Gallard88/Laptop_UPS_PCB/README.md

Laptop UPS PCB
--------

This is a PCB project to provide a 12V & 5V rail to power my ODroid based laptop.
This PCB can source 12V & 5V 4A. It is powered by a 15 - 35V DC supply and upto 
2x 12V SLA batteries.
