Gallard88/Laptop_UPS_PCB/Testing/LaptopPower_RevA.FootprintCheck.xlsx

Description | Designator | Footprint | LibRef | Manufacturer P/N | Checked
FUSE CLIP BLADE 500V 30A PCB | F1, F2 | FUSEHOLDER_BLADE | FUSE_BLADE_500V_30A_PCB | 3522-2 | Visually Inspected
FIXED IND 4.7UH 6.2A 34 MOHM | L1 | Wurth744771156 | IND_4.7uH_6A2 | 74437356047 | Visually Inspected
FIXED IND 56UH 2.01A 110 MOHM | L2 | Wurth744771156 | IND_56uH_2.01A | 744771156 | Visually Inspected
USB A Double Socket | SKT1 | USB_A_DoubleSocket | USB_A_Double |  | Visually Inspected
TERM BLOCK 2POS HORIZ 5.08MM T/H | TRM1, TRM2, TRM3, TRM4, TRM5, TRM6 | TERM_2POS_HORIZ_5.08MM | TRM_2way_ScrewTerminal | 691216510002 | Visually Inspected
SMPS | U1 | PSOP-8 | IC_SMPS_TPS54531 | TPS54531DDA | Visually Inspected
IC REG BUCK 5V 1A 8SOPWRPAD | U2 | PSOP-8 | IC_REG_LM22675 | LM22675MRE-5.0/NOPB | Visually Inspected
