Gallard88/Laptop_UPS_PCB/LaptopPower_RevA.ods

Comment | Description | Manufacturer | Manufacturer P/N | Quantity | Max QTY | Cost | Total
10NF 50V | CAP CER 10NF 50V 10% X7R 0603 | Murata | GRM188R71H103KA01D | 3 | 15 | $0.05 | $0.78
100nF 50V | CAP CER 100nF 50V 10% X7R 0603 | Murata | GRM188R71H104KA93D | 2 | 10 | $0.09 | $0.90
10UF 25V | CAP CER 10UF 25V 10% X5R 1206 | Murata | GRM319R61E106KA12D | 10 | 50 | $0.29 | $14.50
22PF 100V | CAP CER 22PF 100V 5% NP0 0603 | Murata | GRM1885C2A220JA01D | 1 | 5 | $0.08 | $0.39
1nF 50V | CAP CER 1nF 50V 10% X7R 0603 | Murata | GRM188R71H102KA01D | 1 | 5 | $0.05 | $0.26
DIODE_SSC54 | Schottky Diode, 5A, 40V SSC54, DO214AB | Vishay | SSC54-E3/9AT | 3 | 15 | $0.54 | $8.12
DIODE_SS14 | Schottky Diode, 1A, 40V SS14 | Fairchild | SS14 | 4 | 20 | $0.31 | $6.20
BLADE FUSE | FUSE CLIP BLADE 500V 30A PCB | Keystone Electronics | 3522-2 | 2 | 10 | $0.83 | $8.30
4.7uH 6A2 | FIXED IND 4.7UH 6.2A 34 MOHM | Wurth Electronics Inc | 74437356047 | 1 | 5 | $2.77 | $13.85
56uH 2A | FIXED IND 56UH 2.01A 110 MOHM | Wurth Electronics Inc | 744771156 | 1 | 5 | $3.11 | $15.55
Green LED 0805 | WL-SMCW SMD CHIP LED WATERCLEAR | Wurth | 150080VS75000 | 1 | 5 | $0.34 | $1.70
20R 5% | Resistor, 20R, 5%, 2512 | Stackpole Electronics Inc | RMCF2512JT20R0 | 4 | 20 | $0.13 | $2.66
10K2 1% | Resistor, 10K2, 1%, 0603 | Yageo | RC0603FR-0710K2L | 1 | 5 | $0.01 | $0.06
45K3R 1% | Resistor, 45K3, 1%, 0603 | Bourns Inc | CR0603-FX-4532ELF | 1 | 5 | $0.05 | $0.24
1K96 1% | Resistor, 1K96, 1%, 0603 | Yageo | RC0603FR-071K96L | 1 | 5 | $0.02 | $0.08
220R 1% | Resistor, 220R, 1%, 0603 | Bourns Inc | CR0603-FX-2200ELF | 2 | 10 | $0.03 | $0.34
2K2 1% | Resistor, 2K2, 1%, 0603 | Bourns Inc | CR0603-FX-2201ELF | 1 | 5 | $0.05 | $0.24
1K 1% | Resistor, 1K, 1%, 0603 | Bourns Inc | CR0603-FX-1001ELF | 1 | 5 | $0.05 | $0.24
590R 1% | Resistor, 590R, 1%, 0603 | Bourns Inc | CR0603-FX-5900ELF | 1 | 5 | $0.05 | $0.24
USB A Double Socket | USB A Double Socket |  |  | 1 | 5 | $3.50 | $17.50
DC Socket | DC Socket | N/A | N/A | 1 | 5 | $1.60 | $8.00
Wurth 2way screw terminal | TERM BLOCK 2POS HORIZ 5.08MM T/H | Wurth Electronics Inc | 691216510002 | 6 | 30 | $0.90 | $27.00
TPS54531DDA | SMPS | TI | TPS54531DDA | 1 | 5 | $2.02 | $10.10
Buck Reg | IC REG BUCK 5V 1A 8SOPWRPAD | Texas Instruments | LM22675MRE-5.0/NOPB | 1 | 5 | $4.08 | $20.41
PCB |  |  |  | 1 | 1 | $4.00 | $4.00
 |  |  |  |  |  |  | $161.65
