Gallard88/Laptop_UPS_PCB/(list of files, drawings)

Other design files:
LaptopPower_RevA.PcbDoc
LaptopPower_RevA.PrjPcb
LaptopPower_Top_RevA.SchDoc
