Gallard88/Laptop_UPS_PCB/(commit log)

2016-06-02 Laptop Power Supply: Initial Commit.
    [LaptopPower_RevA.FootprintCheck.xlsx, LaptopPower_RevA.PcbDoc, LaptopPower_RevA.PrjPcb, LaptopPower_Top_RevA.SchDoc]
2016-06-02 Updated PCB project.
    [LaptopPower_RevA.PrjPcb]
2016-06-02 Added costing data
    [LaptopPower_RevA.ods]
2016-06-07 Completed visual inspection of new footprints.
    [LaptopPower_RevA.FootprintCheck.xlsx, LaptopPower_RevA.PrjPcb]
2016-06-17 Added PCB price to cost data
    [LaptopPower_RevA.ods]
